ExploreEmbedded/OneMicro-Base-Board/Others/BOM/oneMicro BaseBoard_v0.3.xlsx

 | oneMicro Baseboard v0.3
Id | Designator | Package | Designation | Quantity
1 | RV1 | TO-92 | LM35 Temperature Sensor | 1
2 | U3 | SMD | RGB_SMD_4pin(SMD) | 1
3 | CON3 |  | USB_B Type | 1
4 | CON2 |  | USB_A Type | 1
5 | C3 | SMD(8X10) | Electrolyte Capacitor | 1
6 | SW1 | Through hole | 3pin slide switch | 1
7 | AFF1,AFF2,AFF3,AFF4 | 40 Pin DIP | IC Base | 4
8 | C1,C2,C5,C6,C7,C8 | C_0603 | 0.1uF Ceramic Capacitor | 6
10 | CON1 | Through hole | DC Jack | 1
11 | D1 | SMD | BAT20J Schottkey diode | 1
13 | D3 | L_0603 | Green LED | 1
14 | D2,D5,D6,D7,D8,D10,D11,D12,D13 | L_0603 | RED LED | 9
15 | IC1 | SOT-223 | lm1117_5V(SMD) | 1
16 | IC2 | SOT-223 | lm1117_3.3V(SMD) | 1
17 | IC3 | 16PIN DIP | IC Base | 1
18 | JP2,JP3 | 2PIN , 2.54mm pitch | Pheonix connector | 2
19 | K1 | Sugar cube ,SPDT | RELAY 5V | 1
20 | P8 | 3PIN , 2.54mm pitch | Pheonix connector | 1
22 | R2,R7,R10,R11,R28,R29,R30,R35,R36,R14 | R_0603 | 10k Resistor , 1% | 10
23 | R3,R4 | R_0603 | 33k Resistor , 1% | 2
24 | R5,R6,R20,R21,R22,R23,R31,R32,R33,R34,R1,R12 | R_0603 | 470E Resistor , 1% | 12
25 | R8,R9,R38,R40,R42,R44,R13 | R_0603 | 1k Resistor , 1% | 7
26 | R16 | R_0603 | 2k2 Resistor , 1% | 1
27 | R17 | R_0603 | 150E Resistor , 1% | 1
28 | R18,R19 | R_0603 | 100E Resistor , 1% | 2
29 | SD1 |  | Micro SD Card adapter | 1
30 | SG1 | Through hole | Magnatic Buzzer | 1
31 | U2 | QFN-28 | CP2102-GM | 1
32 | D9 | L_0603 | Blue LED | 1
33 | BT1 | Through hole | Verticle Coin Cell holder | 1
34 | X1 | Through hole | 32.768khz Crystal | 1
36 | R37,R39,R41,R43 | R_0603 | 68E Resistor, 1% | 4
37 | RR1,RR2 | THrough hole, 9pin | 10K Resistor Array | 2
38 | S1 | DIP - 8 | 8 Way Slide switch | 1
39 | U9 | Through hole | Rotary Encoder switch | 1
40 | U1 | SOIC-8 | AT24C16A | 1
41 | U7 | SO-8 | DS1307Z+ | 1
42 | U5 | SOIC-14 | TXB0104D | 1
43 | RV2,RV4,RV5 | Through hole | 10K Preset | 3
44 | SW2,SW3,SW4,SW5 | Through hole | 2pin, Tactile Switch | 4
45 | SW6,7,8,9,10,11,12,13,14,15,16,17,18,19,20,21 | Through hole | 2pin, Tactile Switch | 16
46 | D4 | SOD-80 | 1N4007 Diode | 1
47 | Q1,Q2,Q3,Q4,Q5,Q6 | SOT-23 | BC847 NPN Transistor | 6
48 | R15 | Through hole | 8mm LDR
49 |  | 20 X 2 ( Dual line) | Female Header Black | 3
50 |  | Single line 20 pin | Female Header Black | 1
51 |  | Single line 16 pin | Female Header Black | 1
52 |  | Single line 8 pin | Female Header Black | 2
53 |  | Single line 6 pin | Female Header Black | 1
54 |  | Single line 5 pin | Female Header Black | 1
55 |  | Single line 4 pin | Female Header Black | 4
56 |  | 4 X 2 ( Dual line) | Female Header Black | 3
57 |  | 5 X 2 ( Dual line) | Female Header Black | 1
58 |  | 0.56 inch , Comman Anode | 7 Segment Display -- RED
59 |  | 400 Points | Breadboard | 1
