ExploreEmbedded/OneMicro-Base-Board/(threads)

Thread 1 (2016-10-11):

Legends needs to be changed

raghavendrahassy, 2016-10-11:
Following Legends needs to be changed.
1. Labelled voltages needs to be swapped.
    9V  <-------> 3.3V
2. Pin 1 of Bluetooth module should be "State" pin.
3. RGB LED should have silkscreen with pin 1 should mark.

sharanago, 2017-06-30:
Done

Closed 2017-06-30.

Thread 2 (2016-10-11):

Foot prints needs to be modified

raghavendrahassy, 2016-10-11:
Following Footprints needs to be modified.
1. All BC847 transistor footprint needs to be changed.
2. Diode "D4" footprint needs to be modified.

sharanago, 2017-06-30:
Modified

Closed 2017-06-30.

Thread 3 (2016-10-11):

Relay driving circuit not working

raghavendrahassy, 2016-10-11:
This could be fixed by adding series resistor with indication LED "D3".

sharanago, 2017-06-30:
Added Resistor

Closed 2017-06-30.

Thread 5 (2016-10-18):

4X4 Keypad legend needs to be changed

raghavendrahassy, 2016-10-18:
4X4 Keypad Columns and Rows are wrongly mapped in schematic and even
on the legend.

sharanago, 2017-06-30:
Corrected

Closed 2017-06-30.
