ExploreEmbedded/OneMicro-Base-Board/Harware Design/Verticle coin cell holder.pdf

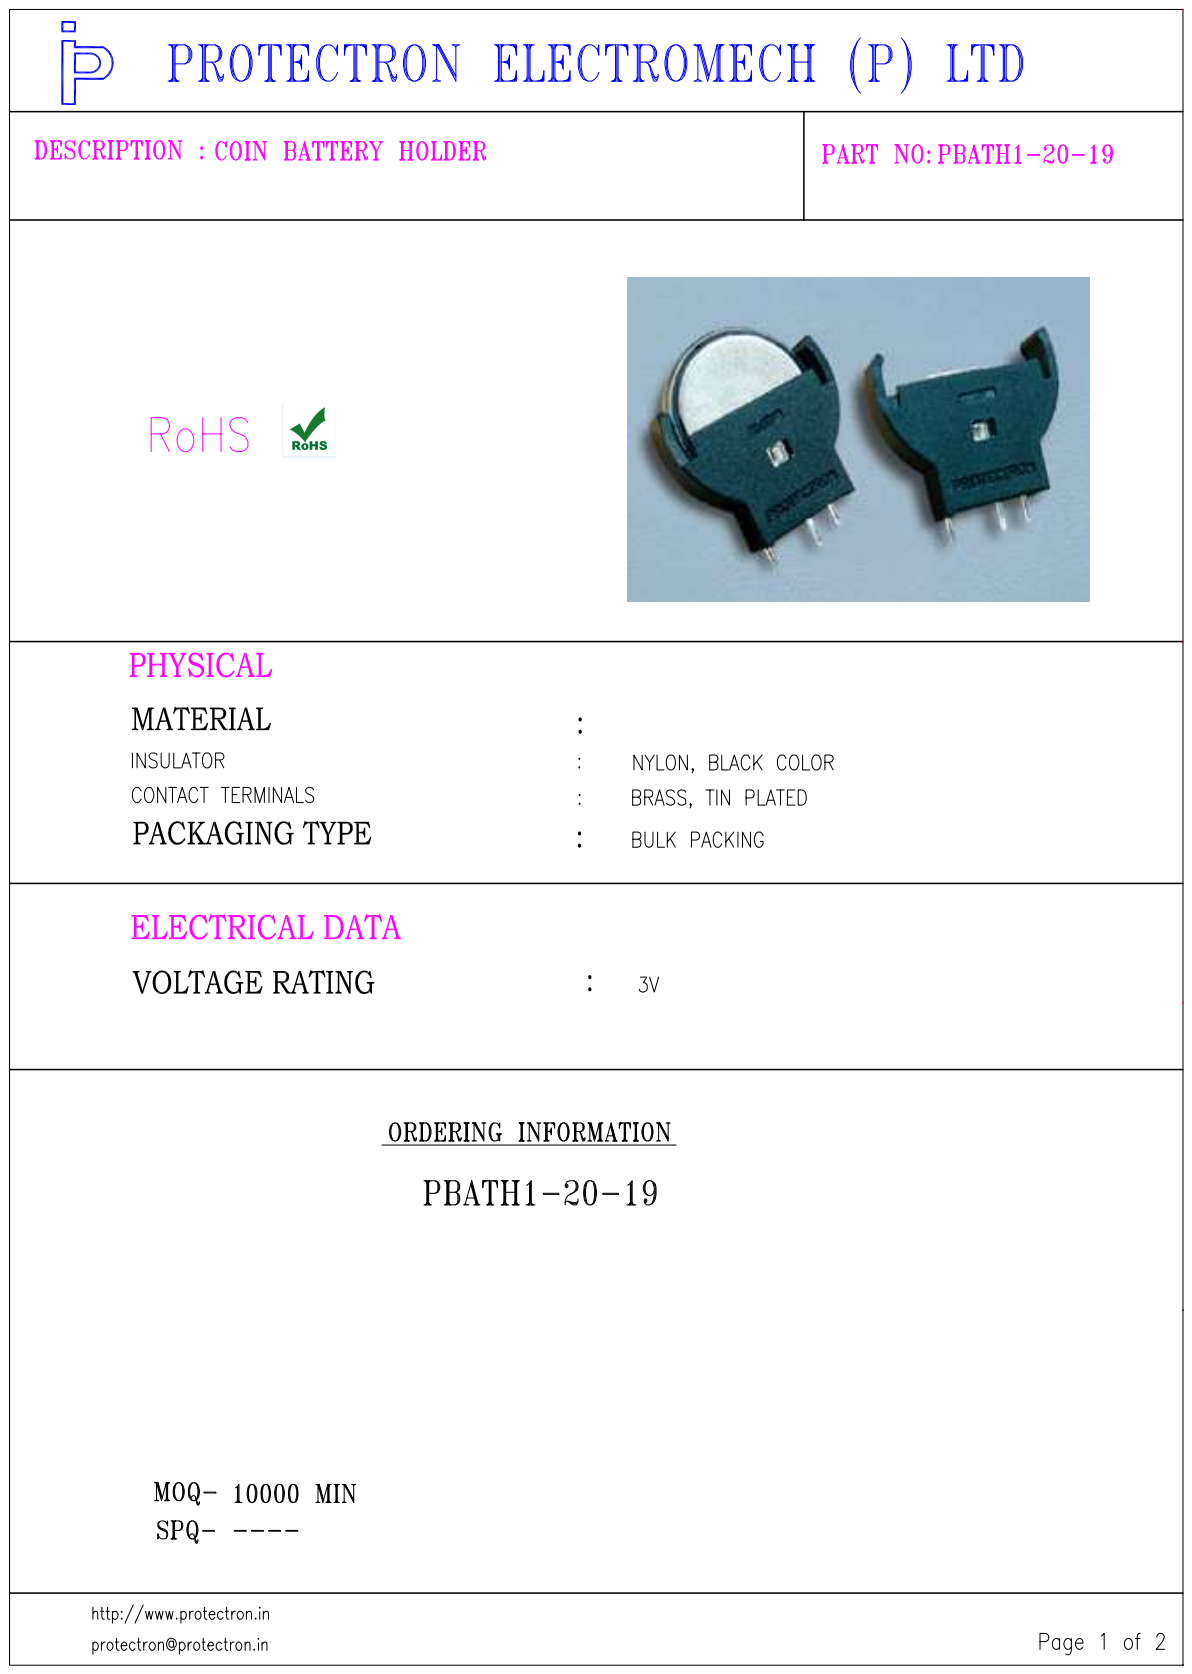
[picture p4: page 1]

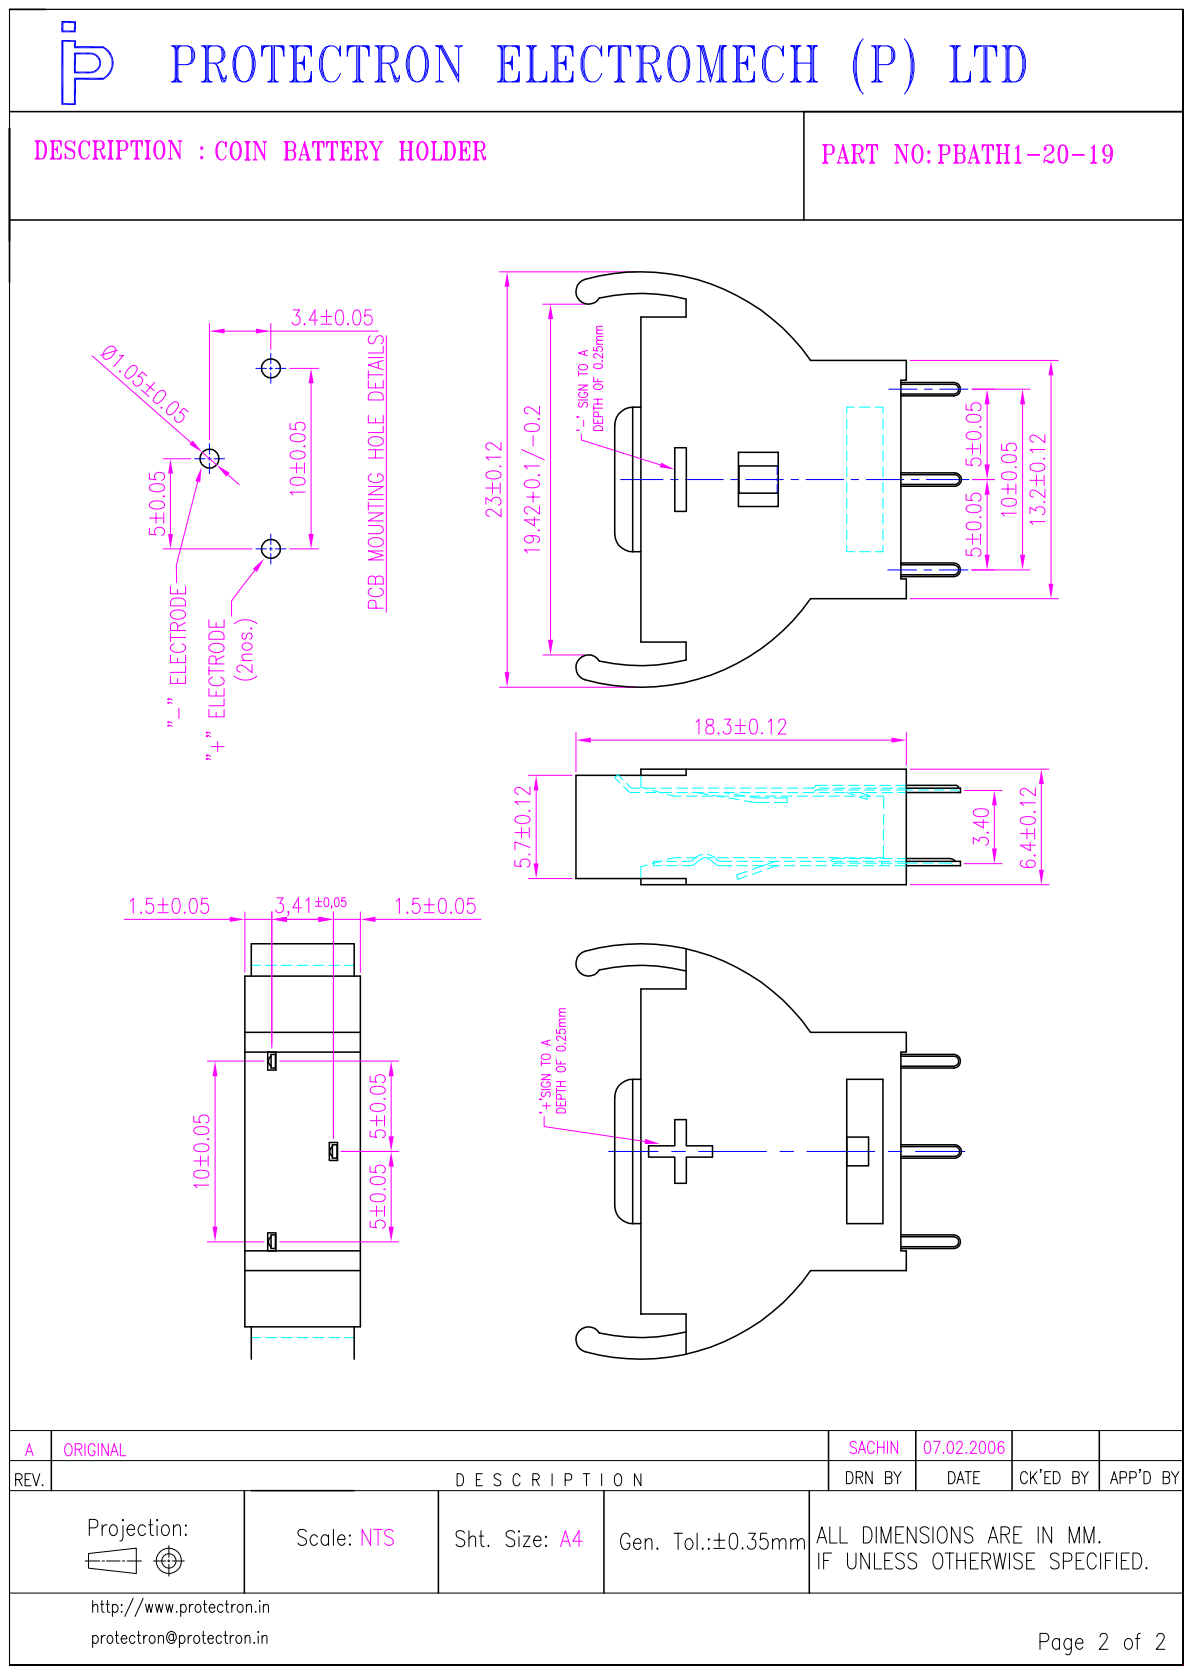
[picture p5: page 2]
