ExploreEmbedded/OneMicro-Base-Board/(commit log)

2016-09-13 Design Files
    [Character_Displays.sch, One Base Board - Copy.brd, One Base Board.kicad_pcb, One Base Board.sch, PSU.sch, Serial Port.sch, USB Host and Device.sch, file559A2D01.sch]
2016-09-14 Legnd Changes
    [One Base Board.kicad_pcb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]
2016-09-15 Relay LED Corrections
    [Character_Displays.sch, One Base Board.kicad_pcb, One Base Board.sch, file57AF0630.sch]
2016-09-21 Gerber file generated
    [One Base Board-B_Cu.gbr, One Base Board-B_Mask.gbr, One Base Board-B_SilkS.gbr, One Base Board-F_Cu.gbr, One Base Board-F_Mask.gbr, One Base Board-F_SilkS.gbr, One Base Board-NPTH.drl, One Base Board.drl]
2016-10-20 Changed design files as per issues
    [Character_Displays.sch, One Base Board.kicad_pcb, One Base Board.sch, file57AF0630.sch]
2016-11-18 Silkscreen added
    [One Base Board.kicad_pcb]
2016-11-19 AddedSilkscreen for Slide switch
    [One Base Board.kicad_pcb]
2016-11-23 RGB LED and D4 footprints are changed
    [Character_Displays.sch, One Base Board.kicad_pcb, One Base Board.sch, file57AF0630.sch]
2017-02-16 Added BOM
    [BOM.xlsx, One Base Board.csv, _saved_One Base Board.sch, _saved_file57AF0630.sch]
2017-06-30 Added Inverted legends
    [One Base Board.kicad_pcb]
2017-07-03 Gerber file generated for v0.3
    [One Base Board-B_Cu.gbr, One Base Board-B_Mask.gbr, One Base Board-B_SilkS.gbr, One Base Board-F_Cu.gbr, One Base Board-F_Mask.gbr, One Base Board-F_SilkS.gbr, One Base Board-NPTH.drl, One Base Board.drl]
2017-07-06 Old gerber files are deleted
    [One Base Board-B.Cu.gbr, One Base Board-B.Mask.gbr, One Base Board-B.SilkS.gbr, One Base Board-B_Cu.gbr, One Base Board-B_Mask.gbr, One Base Board-B_SilkS.gbr, One Base Board-F.Cu.gbr, One Base Board-F.Mask.gbr]
2017-07-11 Gerber file generated for latest version
    [One Base Board-B_Cu.gbr, One Base Board-B_Mask.gbr, One Base Board-B_SilkS.gbr, One Base Board-F_Cu.gbr, One Base Board-F_Mask.gbr, One Base Board-F_SilkS.gbr, One Base Board-NPTH.drl, One Base Board.drl]
2017-07-27 Added updated BOM by deleting older
    [BOM.xlsx, oneMicro BaseBoard_v0.3.xlsx]
2017-09-08 Schematic PDF formate
2018-05-25 Schematic for 7Segment and other added
    [Character_Displays.sch, One Base Board.sch, file57AF0630.sch]
